ASPRNG-PRGMR/EdgeRover/src/bot_controller/receiver/packet.h

#ifndef PACKET_H
#define PACKET_H

#include <stdint.h>

// Bump this if you ever change the layout of ControlPacket.
// The receiver can use it to reject packets from a mismatched build.
// v2: throttle/steering (raw stick axes) replaced with leftPWM/rightPWM
// (final, ready-to-drive PWM duty per side) now that speed comes from
// a potentiometer and steering from a rotary encoder on the transmitter.
// v3: leftPWM/rightPWM changed from uint8_t to int16_t. Sign now
// carries direction, magnitude carries duty (0-255). Needed for tank-
// turn: the inner wheel now reverses past half steering lock instead
// of just tapering toward zero, and idle-throttle + full steer drives
// both wheels in opposite directions for an in-place pivot.
#define PACKET_VERSION 3

// Button bitmask positions (example layout, expand as needed)
#define BTN_A      (1 << 0)
#define BTN_B      (1 << 1)
#define BTN_C      (1 << 2)
#define BTN_D      (1 << 3)

// This struct is sent as-is over ESP-NOW, so it must be byte-identical
// on both the transmitter and receiver. __attribute__((packed)) removes
// any compiler padding so the layout is predictable.
struct __attribute__((packed)) ControlPacket
{
    uint8_t  version;        // PACKET_VERSION, used for sanity checking
    int16_t  leftPWM;        // -255..255, sign = direction, magnitude = duty
    int16_t  rightPWM;       // -255..255, sign = direction, magnitude = duty
    uint8_t  buttons;        // bitmask, see BTN_* defines above
    uint8_t  mode;           // flight/drive mode selector
    uint8_t  armed;          // 0 = disarmed, 1 = armed
    uint32_t packetCounter;  // increments every send, useful for loss stats
};

#endif // PACKET_H
