ASPRNG-PRGMR/EdgeRover/(commit log)

2026-07-09 Replace Bluetooth+L298N control with ESP-NOW PWM control link
    Transmitter (handheld controller):
    - 10k pot sets a shared PWM speed ceiling (0-255), replacing full-speed-only
    D-pad drive and softening motor inrush current
    - Rotary encoder provides differential steering: turning slows only the
    inner wheel, outer wheel holds the ceiling
    - Encoder's built-in pushbutton replaces the dedicated arm switch
    (debounced press-to-toggle)
    - Encoder quadrature decode rewritten as a Buxton-style detent state
    machine - naive edge-interrupt decoding was letting bounce/EMI through
    as steering jitter that time-based debounce alone couldn't catch
    - ILI9225 status screen shows armed state, speed %, ste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
    [display.cpp, display.h, espnow_rx.cpp, espnow_rx.h, espnow_tx.cpp, espnow_tx.h, inputs.cpp, inputs.h]
2026-08-28 docs: pivot README to AprilTag-follower rover, add BEC power rework - Replace ESP-NOW manual-control README with AprilTag visual-following project (steering, distance, and stop math via pinhole camer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
2026-08-29 feat: add AprilTag follower firmware, rework README for vision pivot
    - Add src/vision_control/apriltag_follower/ firmware:
    - camera.h/.cpp — esp32-camera init, grayscale QVGA capture
    - tag_detector.h/.cpp — tag36h11 detection wrapper (UMich apriltag lib)
    - tracker_control.h/.cpp — steering/distance/still-target math,
    forward-only PWM mixing matching existing outer/inner convention
    - constants.h — all tunables/calibration constants as placeholders
    - apriltag_follower.ino — capture -> detect -> control -> send loop
    - packet.h, espnow_tx.h/.cpp — copied byte-identical from
    bot_controller/transmitter/, receiver.ino untouched
    - Update README:
    - Full repo structur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
    [apriltag_follower.ino, camera.cpp, camera.h, constants.h, espnow_tx.cpp, espnow_tx.h, packet.h, tag_detector.cpp]
2026-08-29 docs: switch electrical architecture to isolated dual-battery power
    - Motor domain (12V pack): direct to TB6612FNG VM, BEC 5A to VCC only
    - ESP domain (6V, 4x AA NiMH): direct to ESP32 VIN, onboard AMS1117-3.3
    - No shared rail between domains — only common ground + PWM/direction
    signal wires cross between them, removing motor current spikes as a
    path to ESP32 resets entirely
    - Update wiring checklist and evolution history (4S+caps -> shared 5A
    BEC -> isolated dual-battery)
    [outputs.h, receiver.ino]
2026-08-30 Add dark theme rover power wiring diagram
    Same wiring reference as rover_power_wiring.svg, recolored for a
    black background: lighter wire/ground lines and text for contrast,
    component boxes and domain colors unchanged.
2026-08-30 fix: floor inner-wheel steering PWM; document tank-turn priority; polish power wiring diagram
    - inputs.cpp: add MIN_INNER_FACTOR floor to computeDrive() so hard
    steering while moving no longer zeroes the inner wheel entirely —
    was reachable at full encoder lock, now tapers and holds at a
    tunable minimum instead
    - README: add competition prep roadmap entry — track layout, current
    priority is tuning tank-turn to be as precise as possible; note the
    considered (not built) dual-mode servo-steering idea as conditional
    on competition rules, parked pending confirmation
    - docs: polish rover_power_wiring.svg — black background, brighter
    color-coded wires (red/orange/purple/blue/gre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
    [inputs.cpp]
2026-09-02 feat: fix EN-pin resets under motor load, add tank-turn + pivot steering
    Power fix:
    ESP32 was resetting near full PWM despite an isolated 6V/12V dual-
    battery setup. Traced via USB-power test (rules out supply sag
    entirely) to motor noise coupling onto EN through a non-star ground
    path — reset reason was POWERON_RESET, not brownout.
    - Add 0.1-1uF cap on ESP32 EN->GND
    - Add 0.1uF snubber caps across each motor's terminals
    - Rebuild grounding as a single-point star (was partially daisy-chained)
    - Simplify power arch: one 12V pack + 5A BEC, BEC feeds logic only
    (ESP32 + TB6612 VCC), VM comes straight off the 12V pack
    Confirmed stable across full 0-255 PWM range.
    Steering rework:
    leftPWM/ri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
    [inputs.cpp, inputs.h, outputs.cpp, packet.h]
2026-09-02 feat: upgrade rover to custom metal chassis
    * Replace cardboard prototype with rigid metal chassis and proper mounting holes for motors
    * Add a cardboard enclosure for ESP32 and a battery holder for improved physical protection
    * Update rover assembly to a more robust physical prototype
2026-09-04 - Add src/vision_control/apriltag_follower/apriltag_follower_rover.md: - System architecture, hardware power requirements, and pinout guide - Core control loop pseudocode and math formulas (steering,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
2026-09-05 feat(vision): AprilTag follower with camera tilt, Pythagoras range model, 50 Hz sender + setup guide
    Proofread and rebuilt src/vision_control/apriltag_follower for the
    ESP32-S3-CAM (N16R8 + OV3660) with an SG90 tilting the camera. Compiles
    clean against ESP32 core 3.3.11 + raspiduino/apriltag-esp32
    (PSRAM=opi, huge_app, ~1.0 MB). Not yet tested on hardware.
    Fixes to the existing code
    - constants.h had lost its #ifndef guard (stray #endif, did not compile)
    - sketch was nested one folder too deep, so no module was in the build
    - uncalibrated FOCAL_LENGTH_PX mapped to full speed with no stop; now
    capped at UNCALIBRATED_PWM_CAP until FOCAL_IS_CALIBRATED is set
    - "target stopped" variance heur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
    [calib_example.csv]
