ASPRNG-PRGMR/EdgeRover/images/car.jpg

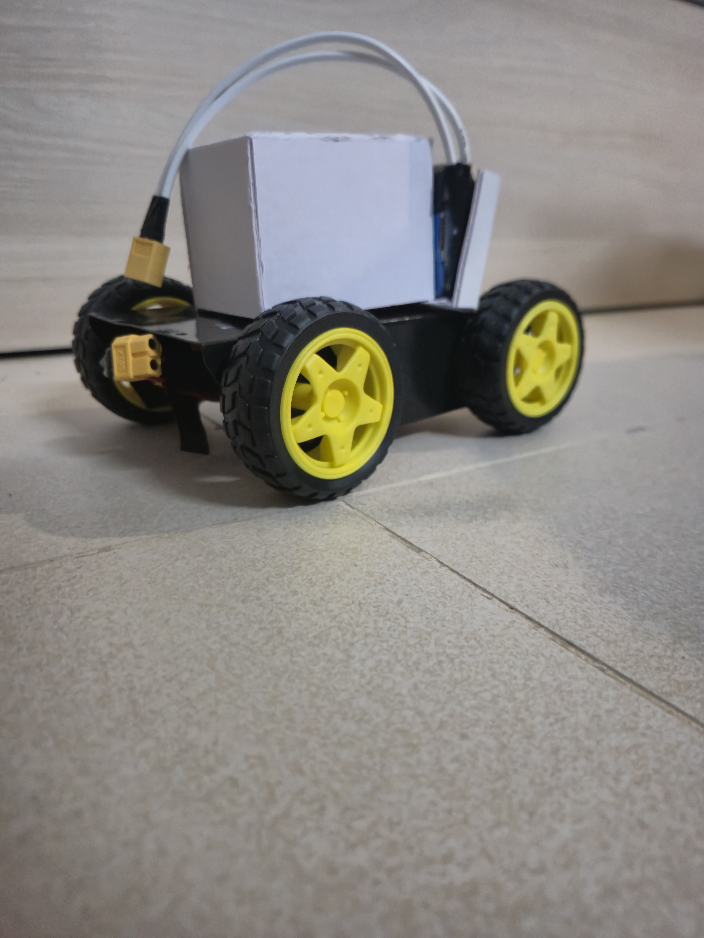
[picture p1: images/car.jpg]
images/car.jpg
